currygood/SelfBalanceCar/note/2026-6-12.md

# 2026-06-12

## I2C 随机读取的硬件实现原理

**核心问题**: 为什么写完地址再读就能"自动"获取寄存器数据？

**答案**: 这不是 MPU6050 的规定，而是 I2C 协议的标准

### 为什么能"自动"实现？

你写的"先写地址、再重复起始、再读数据"的时序，在 I2C 官方标准里被称为 "Random Read（随机读取）" 或 "Memory Read（内存读取）"

几乎所有的 I2C 传感器（EEPROM、陀螺仪、温湿度计）读取寄存器时都用这一套标准时序

### 硬件实现

芯片设计公司（如 ST 意法半导体）深知这一点，所以在设计硬件 I2C 模块时，直接在硬件电路（逻辑门状态机）里写死了这套逻辑

### 时序说明

```
1. 发送起始信号
2. 写入设备地址 + 写标志（表示要配置寄存器）
3. 写入要读取的寄存器地址
4. 重复起始信号
5. 再次发送设备地址 + 读标志（表示要读取数据）
6. 读取数据
```

这套标准时序被硬件固化，所以软件只需要按照步骤调用函数，硬件会自动完成剩余的时序操作
