currygood/SelfBalanceCar/note/2026-6-25.md

# 2026-06-25

研究过程:
在一开始,无论怎么调kp都不行的时候,我就找是不是mpu6050的问题,调了很多次,发现都不行(但其实这中间有一次是能平衡了(kp,ki,kd分别为:18,0,519,74,9.pid算法还是用的是教科书上的),但是会有低频振动,),我就怀疑是不是mpu6050没有机械固定(没有把非引脚那边用螺丝拧到板子上),然后就重新设计板子,发现还是不行,就连用之前能低频振动平衡的都没能平衡.

## 平衡车开发笔记：直立环调优的"生死劫"
- 这个是修复好电源之前的。这里调试的电源是：5V给电机，而且是那种面包板的电源模块，电流是很小的，主要原因是电流太小，跟电压的关系不太大。应该直接把电池连接到电机上，而不是通过面包板的电源模块。
- 然后确实换了算法之后有所提升，在电源没问题的板子上也是需要用这个算法的.

### 1. 背景

在开发双轮平衡车时，虽然设计目标是实现"直立、速度、转向"三环控制，但**直立环（内环）**是所有功能的基石。直立环的任务是输出 PWM 直接作用于电机，抵消车身倾斜的重力力矩。如果直立环不稳，后续的速度环和转向环将完全失去调试的前提。

### 2. 栽跟头的原因分析

#### A. 机械特性的"视而不见"（电机死区）(影响很小)
- **痛点**: PID 计算出的微小输出无法克服 TT 电机减速箱的静摩擦力
- **后果**: 小车在小角度时"毫无反应"，在大角度时"用力过猛"，系统存在严重的非线性死区

#### B. 采样频率与微分项的量级误区(最重要的原因)
- **痛点**: 沿用教科书公式 Kd * (Error0 - Error1)，但在 5ms 的高频采样下，两次误差的差值极小
- **后果**: Kd 参数在逻辑上几乎失效。为了产生阻尼感被迫将 Kd 加到几百，结果引入了巨大的离散噪声，诱发电机高频打冷颤

#### C. 硬件总线的隐形干扰(几乎不太可能)
- **痛点**: 认为 OLED 使用 DMA 发送就不会干扰控制
- **后果**: DMA 虽然不占 CPU，但会长时间霸占 I2C 总线，导致 Control_Task 读取 MPU6050 阻塞，5ms 的控制周期变成随机值。对于平衡控制，频率不稳等于自杀

### 3. 解决办法：三步走突破

#### 第一步：引入"死区补偿"，赋予电机灵性
- **对策**: 测量电机起步 PWM（如 12），并在 PID 输出的基础上根据正负号直接叠加补偿量
- **结果**: 实现了"微小角度、微小响应"，让电机在平衡点附近能够进行细腻的微调

#### 第二步：微分项进化——"陀螺仪先行"
- **对策**: 彻底放弃角度差分，直接利用陀螺仪的原始角速度（Gyro_X）作为微分项输入
- **结果**:
  - Kp 负责"回正"的力
  - Kd 负责"阻碍"倒下的速度
  - 量级革命：Kd 从几百的无效值回落到 0.5 ~ 1.5 的精准区间，车身表现从"震动"变为"丝滑"

#### 第三步：净化总线，确保频率刚性
- **对策**: 调试期间彻底屏蔽 OLED 刷新任务，将重心放回传感器数据的实时性
- **结果**: 确保了 200Hz（5ms）控制频率的绝对稳定，使微分补偿能够精准对冲物理惯性

### 4. 关键参数复盘

- **Kp = 25**: 提供了足够的回正刚度
- **Kd = 1.0** (角速度输入): 提供了完美的动态阻尼
- **MECHANICAL_MEDIAN = -0.05**: 找准了肉眼难辨的物理重心中心

### 5. 应用方向

平衡控制是自动化控制中的"明珠"，掌握了直立环的调试逻辑，可以延伸到：
- 倒立摆系统：工业机器人手臂的精确停顿控制
- 运载工具：独轮平衡车、自平衡摩托车
- 航空航天：火箭垂直起降（VTVL）中的矢量推进推力补偿
- 运动相机：电子防抖（EIS）中对高频抖动的物理抑制算法

### 6. 开发者寄语

> 电源是最重要的！！！ 不同的模块要区分好使用什么样的电源，不要盲目选择

> "栽跟头通常不是因为公式错了，而是因为忽略了物理世界的摩擦与延迟。"
>
> 在直立环中，算法必须向硬件妥协（死区补偿），数据必须向延迟宣战（微分先行）。只有内环稳如泰山，外环的逻辑（速度、角度）才有意义。
