currygood/SelfBalanceCar/note/2026-6-13.md

# 2026-06-13

## OLED 分页异步更新（RTOS专用）

**设计场景**: 平衡车控制项目，MPU6050需要经常获取数据，OLED屏幕不能占用时间过长

**关键设计**:
- I2C分页异步更新，每次仅发送128字节（1页）
- 刷新全屏需要连续调用8次
- 在I2C空闲时传输
- 在System_Task而不是控制任务中执行

**函数特点**:
- 先检查总线是否空闲
- 异步发送不等待完成
- 自动循环更新8页

**核心价值**: 不占用I2C总线时间，保证MPU6050数据获取的实时性
