currygood/SelfBalanceCar/note/2026-6-16.md

# 2026-06-16

## 无符号数差值计算处理

**场景**: 定时器计数器从 65535 回绕到 0 时计算差值

**关键点**:
- 无符号数不需要额外处理
- 直接相减即可，C语言自动处理模运算

**示例** (uint16_t, last=65530, now=1):
- 数学真值: 1 - 65530 = -65529
- 无符号减法: (1 - 65530) mod 65536 = 7
- 结果7是从65530走到1实际经过的步数

**代码片段**:
```c
Dis_TimeTick_Get = DWT_Get_Cnt() - Dis_Last_TimeTick;
```

**重要提示**:
- 不要直接用无符号数做带符号判断，因为无符号数没有负数概念
- 要处理方向就需要有符号数，然后用上面提到的相加相减处理

## pid算法设计
### MPU6050获得稳定的角度变化
加速度计是测量重力分量，通过三角函数 tan=Ax/Ay   然后反三角得到角度    优点是静态稳定，长时间不漂移，但是动态稳定性差，容易受冲击力影响
陀螺仪通过角速度得到角度，优点和缺点都是与加速度计反着来
所以需要融合他们两个，取长补短  
#### 互补滤波 
以陀螺仪为主，参考加速度计角度，修正陀螺仪的漂移，同时为陀螺仪提供绝对参考（加速度以重力为绝对参考）
公式：  互补得到的角度 = x\*acc角度 + （1-a）\*gyro角度   

设计算法的时候要注意，"gyro角度""计算的时候要用上次计算得到的""互补得到的角度"，不然每次都是白滤波，根本没有消除陀螺仪漂移问题。
