currygood/SelfBalanceCar/note/PID调参过程.md

# PID调参过程

## 没弄好电源之前
### 只有直立环
在一开始,无论怎么调kp都不行的时候,我就找是不是mpu6050的问题,调了很多次,发现都不行(但其实这中间有一次是能平衡了(kp,ki,kd分别为:18,0,519,74,9.pid算法还是用的是教科书上的),但是会有低频振动,),我就怀疑是不是mpu6050没有机械固定(没有把非引脚那边用螺丝拧到板子上),然后就重新设计板子,发现还是不行,就连用之前能低频振动平衡的都没能平衡。然后换了一种PID计算的能够平衡了，而且我感觉这种平衡还不错。

### 有直立环和转向环
会在原地低频抖动的同时前后移动比较长的距离，怎么调都没用。因此，我决定重新审视硬件，发现电源不行！！！

## 为什么电源不行
- 电源电压不足（这不是主要原因）：我把7.4v的电池连接到面包板电源模块上，这个模块会输出3v3和5v的电压，我当时觉得很不错，可以给stm32主控和mpu6050等外设供电的同时给电机供电（TB6612电机驱动和电机编码器模块）。但是这个面包板电源输出的电流是不够的，不超过800MA，所以由此也知道是电流的主要问题
- 电流太小：给TB6612电机驱动的电流实在太小了，这个面包板使用的是LDO，最大输出才1A，而且因为发热，实际工作的时候可能会500-800MA左右，太小了，电机的驱动能力就不足了，导致车的平衡能力也不足了。

## 弄好了电源:
很快就调参成功了，直立环调的很快，然后加入速度环，调了一会也成功了，能够正常平衡，而且按照一定速度保持，不会抖动。（注：这里的速度是指车的移动速度，不是电机的转速）
然后就加入转向环，接着就通过vibe coding开发的手机蓝牙控制app控制小车运动，能够实现转向，前后移动，往前左方走等操作。完整实现闭环
