currygood/SelfBalanceCar/Core/Inc/main.h

#define BLE_State_Pin GPIO_PIN_1
#define BLE_State_GPIO_Port GPIOA
#define Trig_Pin GPIO_PIN_4
#define Trig_GPIO_Port GPIOA
#define Echo_Pin GPIO_PIN_5
#define Echo_GPIO_Port GPIOA
#define Echo_EXTI_IRQn EXTI9_5_IRQn
#define AIN1_Pin GPIO_PIN_12
#define AIN1_GPIO_Port GPIOB
#define AIN2_Pin GPIO_PIN_13
#define AIN2_GPIO_Port GPIOB
#define BIN1_Pin GPIO_PIN_14
#define BIN1_GPIO_Port GPIOB
#define BIN2_Pin GPIO_PIN_15
#define BIN2_GPIO_Port GPIOB
